MinhHieu15/self-balancing-robot/sbr3/docs/drc_report.txt

** Drc report for SBR3.kicad_pcb **
** Created on 2026-11-12T20:24:28 **
** Report includes: Errors **

** Found 0 DRC violations **

** Found 0 unconnected pads **

** Found 0 Footprint errors **

** Ignored checks **
    - Footprint has no courtyard defined
    - Track endpoint not centered on via
    - Tuning profile track geometries
    - Footprint doesn't match symbol's footprint filters
    - PTH inside courtyard
    - NPTH inside courtyard
    - Footprint component type doesn't match footprint pads

** End of Report **
