MinhHieu15/self-balancing-robot/docs/sim_push.png

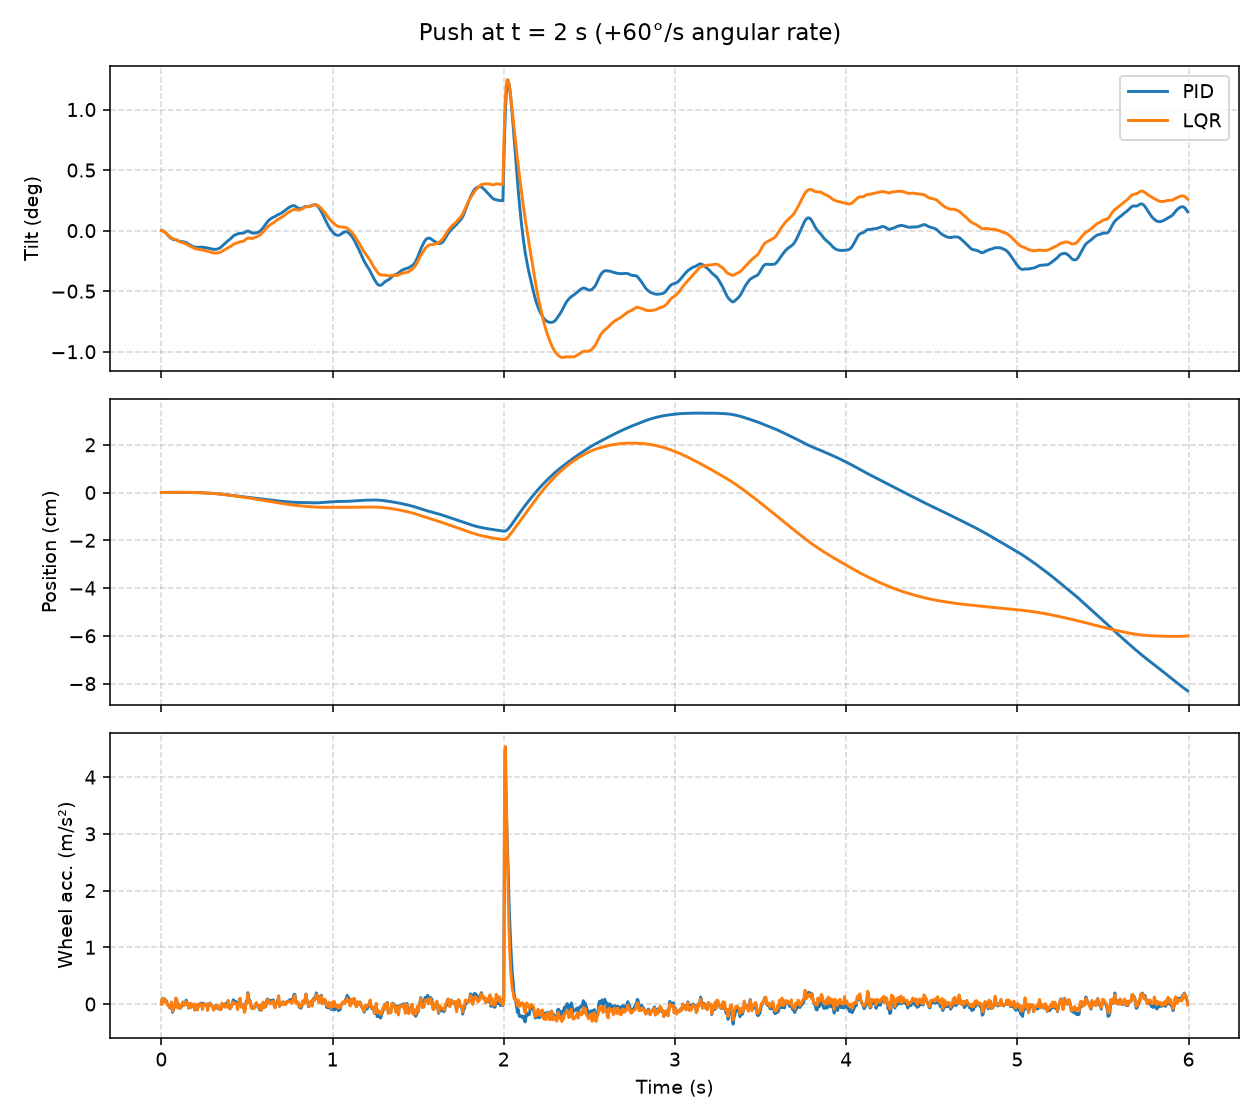
docs/sim_push.png
