MinhHieu15/self-balancing-robot/sbr3/docs/SBR3_3d_overview_back.png

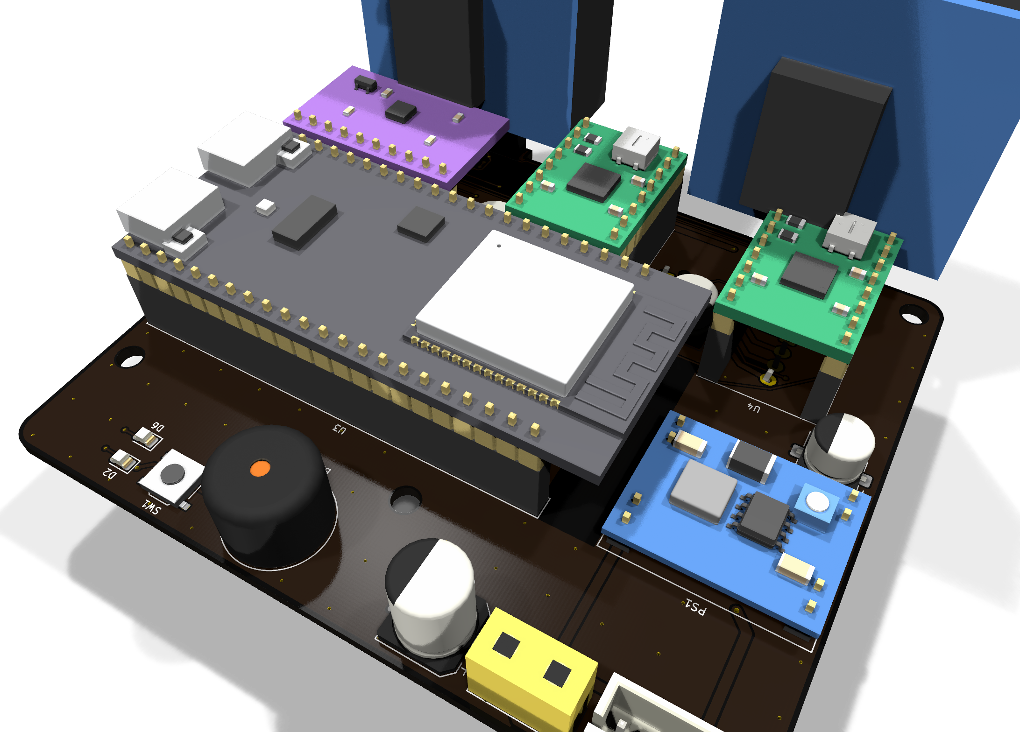
sbr3/docs/SBR3_3d_overview_back.png
