MinhHieu15/self-balancing-robot/sbr3/SBR3_BOM.csv

Reference | Value | Footprint | Qty
BZ1 | Buzzer 5V | workspace_components_Buzzer:Buzzer_12x9.5RM7.6 | 1
C1,C2,C5 | 10uF 10V X5R | stdlib_kicad-footprints_Capacitor_SMD:C_0805_2012Metric | 3
C3,C4,C6,C7,C10,C19,C21 | 100nF 16V X7R | stdlib_kicad-footprints_Capacitor_SMD:C_0805_2012Metric | 7
C8,C11 | 47uF 35V | workspace_components_CP_47uF_35V:CP_Elec_6.3x5.8 | 2
C9,C12,C14 | 100nF 50V X7R | stdlib_kicad-footprints_Capacitor_SMD:C_0805_2012Metric | 3
C13 | 10uF 50V X5R | stdlib_kicad-footprints_Capacitor_SMD:C_1206_3216Metric | 1
C15 | 22uF 25V X5R | stdlib_kicad-footprints_Capacitor_SMD:C_1206_3216Metric | 1
C16 | 22nF 50V X7R | stdlib_kicad-footprints_Capacitor_SMD:C_0805_2012Metric | 1
C17 | 680nF 25V X7R | stdlib_kicad-footprints_Capacitor_SMD:C_0805_2012Metric | 1
C18 | 100uF 16V | workspace_components_CP_100uF_16V:CP_Elec_6.3x5.8 | 1
C20 | 100uF 35V | workspace_components_CP_100uF_35V:CP_Elec_8x10 | 1
D1 | 3A 40V Schottky Rectifier | stdlib_kicad-footprints_Diode_SMD:D_SMA | 1
D2 | LED GREEN | stdlib_kicad-footprints_LED_SMD:LED_0805_2012Metric | 1
D3 | 10V Zener | stdlib_kicad-footprints_Diode_SMD:D_SOD-123 | 1
D4 | 15V TVS Diode | stdlib_kicad-footprints_Diode_SMD:D_SMB | 1
D5 | 75V PN Rectifier | stdlib_kicad-footprints_Diode_SMD:D_SOD-123 | 1
D6 | LED BLUE | stdlib_kicad-footprints_LED_SMD:LED_0805_2012Metric | 1
F1 | PTC 2.6A hold 33V | workspace_components_Polyfuse:Fuse_2920_7451Metric | 1
J1,J2 | Conn_01x05 | workspace_components_Conn_01x05:PinSocket_1x05_P2.54mm_Vertical | 2
J3,J4,J6 | Conn_01x04 | workspace_components_Conn_01x04:JST_XH_B4B-XH-AM_1x04_P2.50mm_Vertical | 3
J5 | Conn_01x02 | workspace_components_Conn_01x02:AMASS_XT30U-M_1x02_P5.0mm_Vertical | 1
PS1 | MP1584EN_Module | workspace_components_MP1584EN_Module:MP1584EN_Module_22x17mm | 1
Q1,Q2 | AO3401A | workspace_components_AO3401A:SOT-23 | 2
Q3 | MMBT3904 | workspace_components_MMBT3904:SOT-23 | 1
R1,R2,R5,R11,R13 | 10k | stdlib_kicad-footprints_Resistor_SMD:R_0805_2012Metric | 5
R3,R4 | 4.7k | stdlib_kicad-footprints_Resistor_SMD:R_0805_2012Metric | 2
R6,R12 | 1k | stdlib_kicad-footprints_Resistor_SMD:R_0805_2012Metric | 2
R7 | 220k | stdlib_kicad-footprints_Resistor_SMD:R_0805_2012Metric | 1
R8 | 0 | stdlib_kicad-footprints_Resistor_SMD:R_0805_2012Metric | 1
R9 | 22k | stdlib_kicad-footprints_Resistor_SMD:R_0805_2012Metric | 1
R10 | 100k | stdlib_kicad-footprints_Resistor_SMD:R_0805_2012Metric | 1
R14 | 330 | stdlib_kicad-footprints_Resistor_SMD:R_0805_2012Metric | 1
SW1 | SW_Push | workspace_components_SW_Push:SW_Push_1P1T_XKB_TS-1187A | 1
U1 | 74AHCT125 | workspace_components_74AHCT125:SOIC-14_3.9x8.7mm_P1.27mm | 1
U2 | GY-9250 | workspace_components_GY-9250:PinSocket_1x10_P2.54mm_Vertical | 1
U3 | ESP32-S3-DevKitC-1 | workspace_components_ESP32-S3-DevKitC-1:ESP32-S3-DevKitC-1 | 1
U4,U5 | A4988_STEPPER_MOTOR_DRIVER_CARRIER | workspace_components_A4988_STEPPER_MOTOR_DRIVER_CARRIER:MODULE_A4988_STEPPER_MOTOR_DRIVER_CARRIER | 2
