MinhHieu15/self-balancing-robot/mechanical/robot_assembly.step

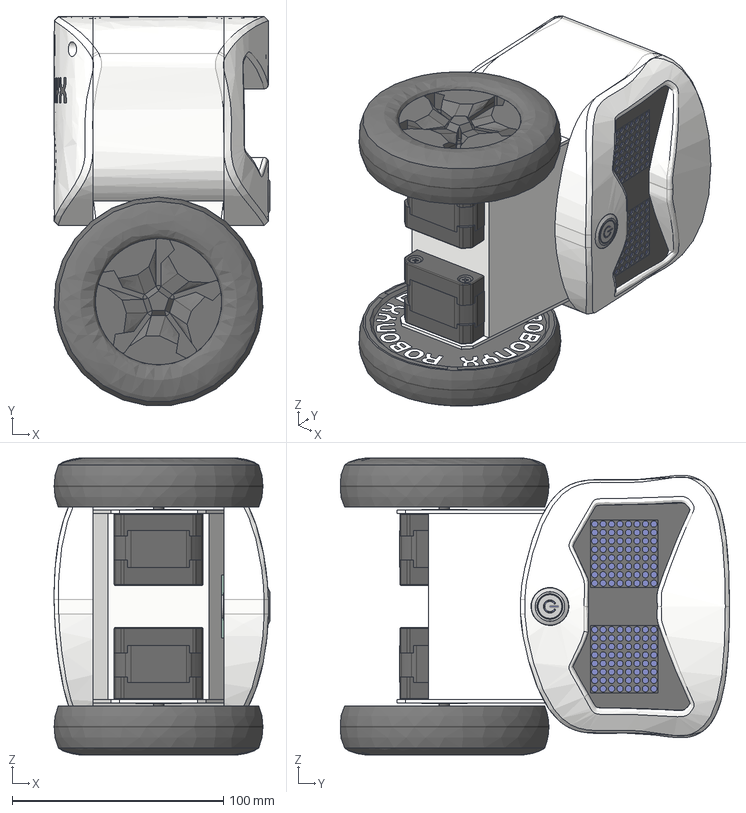
[picture p12: CAD file, 2026-11-12]
mechanical/robot_assembly.step
102.1 x 184.2 x 140.6 mm
pololu-universal-aluminum-mounting-hub-for-5mm-shaft-4-40-holes v1 x 2
Motor x 2
Board_8x8_Dot_Matrix x 2
LED_Matrix x 2
hdrf-1x8t_2.54_21x3 x 4
Metal LED Illuminated Latching 16mm Power Push Button ON-OFF Switch 1 2V (1)
Metal LED Illuminated Latching 16mm Power Push Button ON-OFF Switch 1 2V (2)
Motor Mount v1
CP_Radial_D63mm_P250mm x 2
R_0805_2012Metric_1 x 3
A4988 STEPPER MOTOR DRIVER CARRIER BLACK x 2
C_0805_2012Metric_1 x 3
LED_D5.0mm_1
CQ assembly
PinSocket_1x05_P254mm_Vertical x 2
Adafruit BNO055 STEMMA QT with headers v1
ESP32-DEVKITC_1
D_DO-35_SOD27_P10.16mm_Horizontal_1
JST_B4B_XH_A x 2
SBR2.1_PCB
