MinhHieu15/self-balancing-robot/simulation/results/filter_alpha.csv

alpha | angle_rmse_deg
0.9 | 0.3499
0.94 | 0.2760
0.96 | 0.2385
0.98 | 0.2376
0.99 | 0.3793
0.995 | 0.6984
0.998 | 1.3652
