MinhHieu15/self-balancing-robot/simulation/results/loop_delay.csv

delay_ms | ITAE_PID | ITAE_LQR
0.0 | 0.0525 | 0.0715
5.0 | 0.0529 | 0.0717
10.0 | 0.0534 | 0.0721
15.0 | 0.0540 | 0.0727
20.0 | 0.0557 | 0.0736
25.0 | 0.0822 | 0.0765
30.0 | 0.9472 | 0.5743
35.0 | nan | 0.8431
40.0 | nan | 1.1997
