MinhHieu15/self-balancing-robot/simulation/results/push_lqr.csv

t_s | x_m | v_mps | theta_deg | theta_est_deg | omega_dps | wheel_acc_mps2
0.000 | 0.0000 | 0.0000 | 0.000 | 0.017 | 0.00 | 0.000
0.005 | 0.0000 | 0.0005 | -0.001 | 0.026 | -0.39 | 0.101
0.010 | 0.0000 | 0.0006 | -0.003 | 0.056 | -0.46 | 0.018
0.015 | 0.0000 | 0.0010 | -0.006 | 0.042 | -0.79 | 0.087
0.020 | 0.0000 | 0.0014 | -0.011 | 0.053 | -1.10 | 0.079
0.025 | 0.0000 | 0.0017 | -0.017 | 0.053 | -1.31 | 0.053
0.030 | 0.0000 | 0.0019 | -0.024 | 0.027 | -1.49 | 0.044
0.035 | 0.0000 | 0.0018 | -0.032 | 0.009 | -1.44 | -0.016
0.040 | 0.0000 | 0.0018 | -0.039 | 0.006 | -1.44 | -0.007
0.045 | 0.0001 | 0.0016 | -0.046 | -0.022 | -1.30 | -0.044
0.050 | 0.0001 | 0.0013 | -0.052 | -0.026 | -1.10 | -0.061
0.055 | 0.0001 | 0.0010 | -0.057 | 0.014 | -0.93 | -0.055
0.060 | 0.0001 | 0.0012 | -0.062 | -0.075 | -1.10 | 0.037
0.065 | 0.0001 | 0.0005 | -0.066 | -0.083 | -0.65 | -0.131
0.070 | 0.0001 | 0.0001 | -0.068 | -0.075 | -0.36 | -0.086
0.075 | 0.0001 | -0.0000 | -0.070 | -0.012 | -0.31 | -0.026
0.080 | 0.0001 | -0.0002 | -0.071 | -0.016 | -0.27 | -0.023
0.085 | 0.0001 | 0.0004 | -0.074 | 0.007 | -0.73 | 0.109
0.090 | 0.0001 | 0.0007 | -0.079 | -0.015 | -1.04 | 0.069
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
