MinhHieu15/self-balancing-robot/simulation/results/push_pid.csv

t_s | x_m | v_mps | theta_deg | theta_est_deg | omega_dps | wheel_acc_mps2
0.000 | 0.0000 | 0.0000 | 0.000 | 0.017 | 0.00 | 0.000
0.005 | 0.0000 | 0.0004 | -0.001 | 0.026 | -0.34 | 0.088
0.010 | 0.0000 | 0.0006 | -0.003 | 0.057 | -0.44 | 0.027
0.015 | 0.0000 | 0.0011 | -0.006 | 0.043 | -0.81 | 0.097
0.020 | 0.0000 | 0.0015 | -0.011 | 0.053 | -1.14 | 0.083
0.025 | 0.0000 | 0.0018 | -0.017 | 0.053 | -1.39 | 0.065
0.030 | 0.0000 | 0.0021 | -0.025 | 0.026 | -1.62 | 0.057
0.035 | 0.0000 | 0.0021 | -0.033 | 0.008 | -1.62 | -0.006
0.040 | 0.0001 | 0.0020 | -0.041 | 0.004 | -1.61 | -0.009
0.045 | 0.0001 | 0.0018 | -0.049 | -0.025 | -1.47 | -0.043
0.050 | 0.0001 | 0.0014 | -0.056 | -0.030 | -1.24 | -0.070
0.055 | 0.0001 | 0.0011 | -0.061 | 0.010 | -1.02 | -0.068
0.060 | 0.0001 | 0.0012 | -0.067 | -0.080 | -1.15 | 0.025
0.065 | 0.0001 | 0.0005 | -0.071 | -0.088 | -0.64 | -0.147
0.070 | 0.0001 | -0.0001 | -0.073 | -0.080 | -0.25 | -0.113
0.075 | 0.0001 | -0.0004 | -0.074 | -0.017 | -0.08 | -0.058
0.080 | 0.0001 | -0.0005 | -0.074 | -0.019 | -0.04 | -0.022
0.085 | 0.0001 | -0.0000 | -0.075 | 0.005 | -0.43 | 0.089
0.090 | 0.0001 | 0.0003 | -0.078 | -0.015 | -0.74 | 0.068
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
