MinhHieu15/self-balancing-robot/simulation/results/tilt10_lqr.csv

t_s | x_m | v_mps | theta_deg | theta_est_deg | omega_dps | wheel_acc_mps2
0.000 | 0.0000 | 0.0000 | 10.018 | 10.017 | 6.51 | 0.000
0.005 | 0.0001 | 0.0300 | 10.006 | 10.059 | -9.54 | 6.000
0.010 | 0.0003 | 0.0600 | 9.914 | 10.043 | -25.62 | 6.000
0.015 | 0.0007 | 0.0900 | 9.742 | 9.905 | -41.80 | 6.000
0.020 | 0.0012 | 0.1152 | 9.498 | 9.712 | -54.50 | 5.040
0.025 | 0.0018 | 0.1349 | 9.202 | 9.447 | -63.22 | 3.930
0.030 | 0.0026 | 0.1499 | 8.871 | 9.114 | -68.69 | 3.013
0.035 | 0.0033 | 0.1612 | 8.519 | 8.764 | -71.55 | 2.262
0.040 | 0.0042 | 0.1701 | 8.158 | 8.413 | -72.78 | 1.765
0.045 | 0.0050 | 0.1769 | 7.795 | 8.031 | -72.71 | 1.360
0.050 | 0.0059 | 0.1822 | 7.434 | 7.673 | -71.81 | 1.076
0.055 | 0.0069 | 0.1867 | 7.079 | 7.362 | -70.42 | 0.885
0.060 | 0.0078 | 0.1908 | 6.730 | 6.928 | -69.05 | 0.830
0.065 | 0.0088 | 0.1936 | 6.391 | 6.583 | -66.85 | 0.550
0.070 | 0.0097 | 0.1961 | 6.063 | 6.263 | -64.70 | 0.507
0.075 | 0.0107 | 0.1986 | 5.745 | 6.006 | -62.72 | 0.497
0.080 | 0.0117 | 0.2008 | 5.437 | 5.692 | -60.74 | 0.441
0.085 | 0.0127 | 0.2034 | 5.137 | 5.415 | -59.26 | 0.522
0.090 | 0.0138 | 0.2056 | 4.846 | 5.102 | -57.66 | 0.438
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
