MinhHieu15/self-balancing-robot/sbr3/docs/SBR3_schematic.pdf

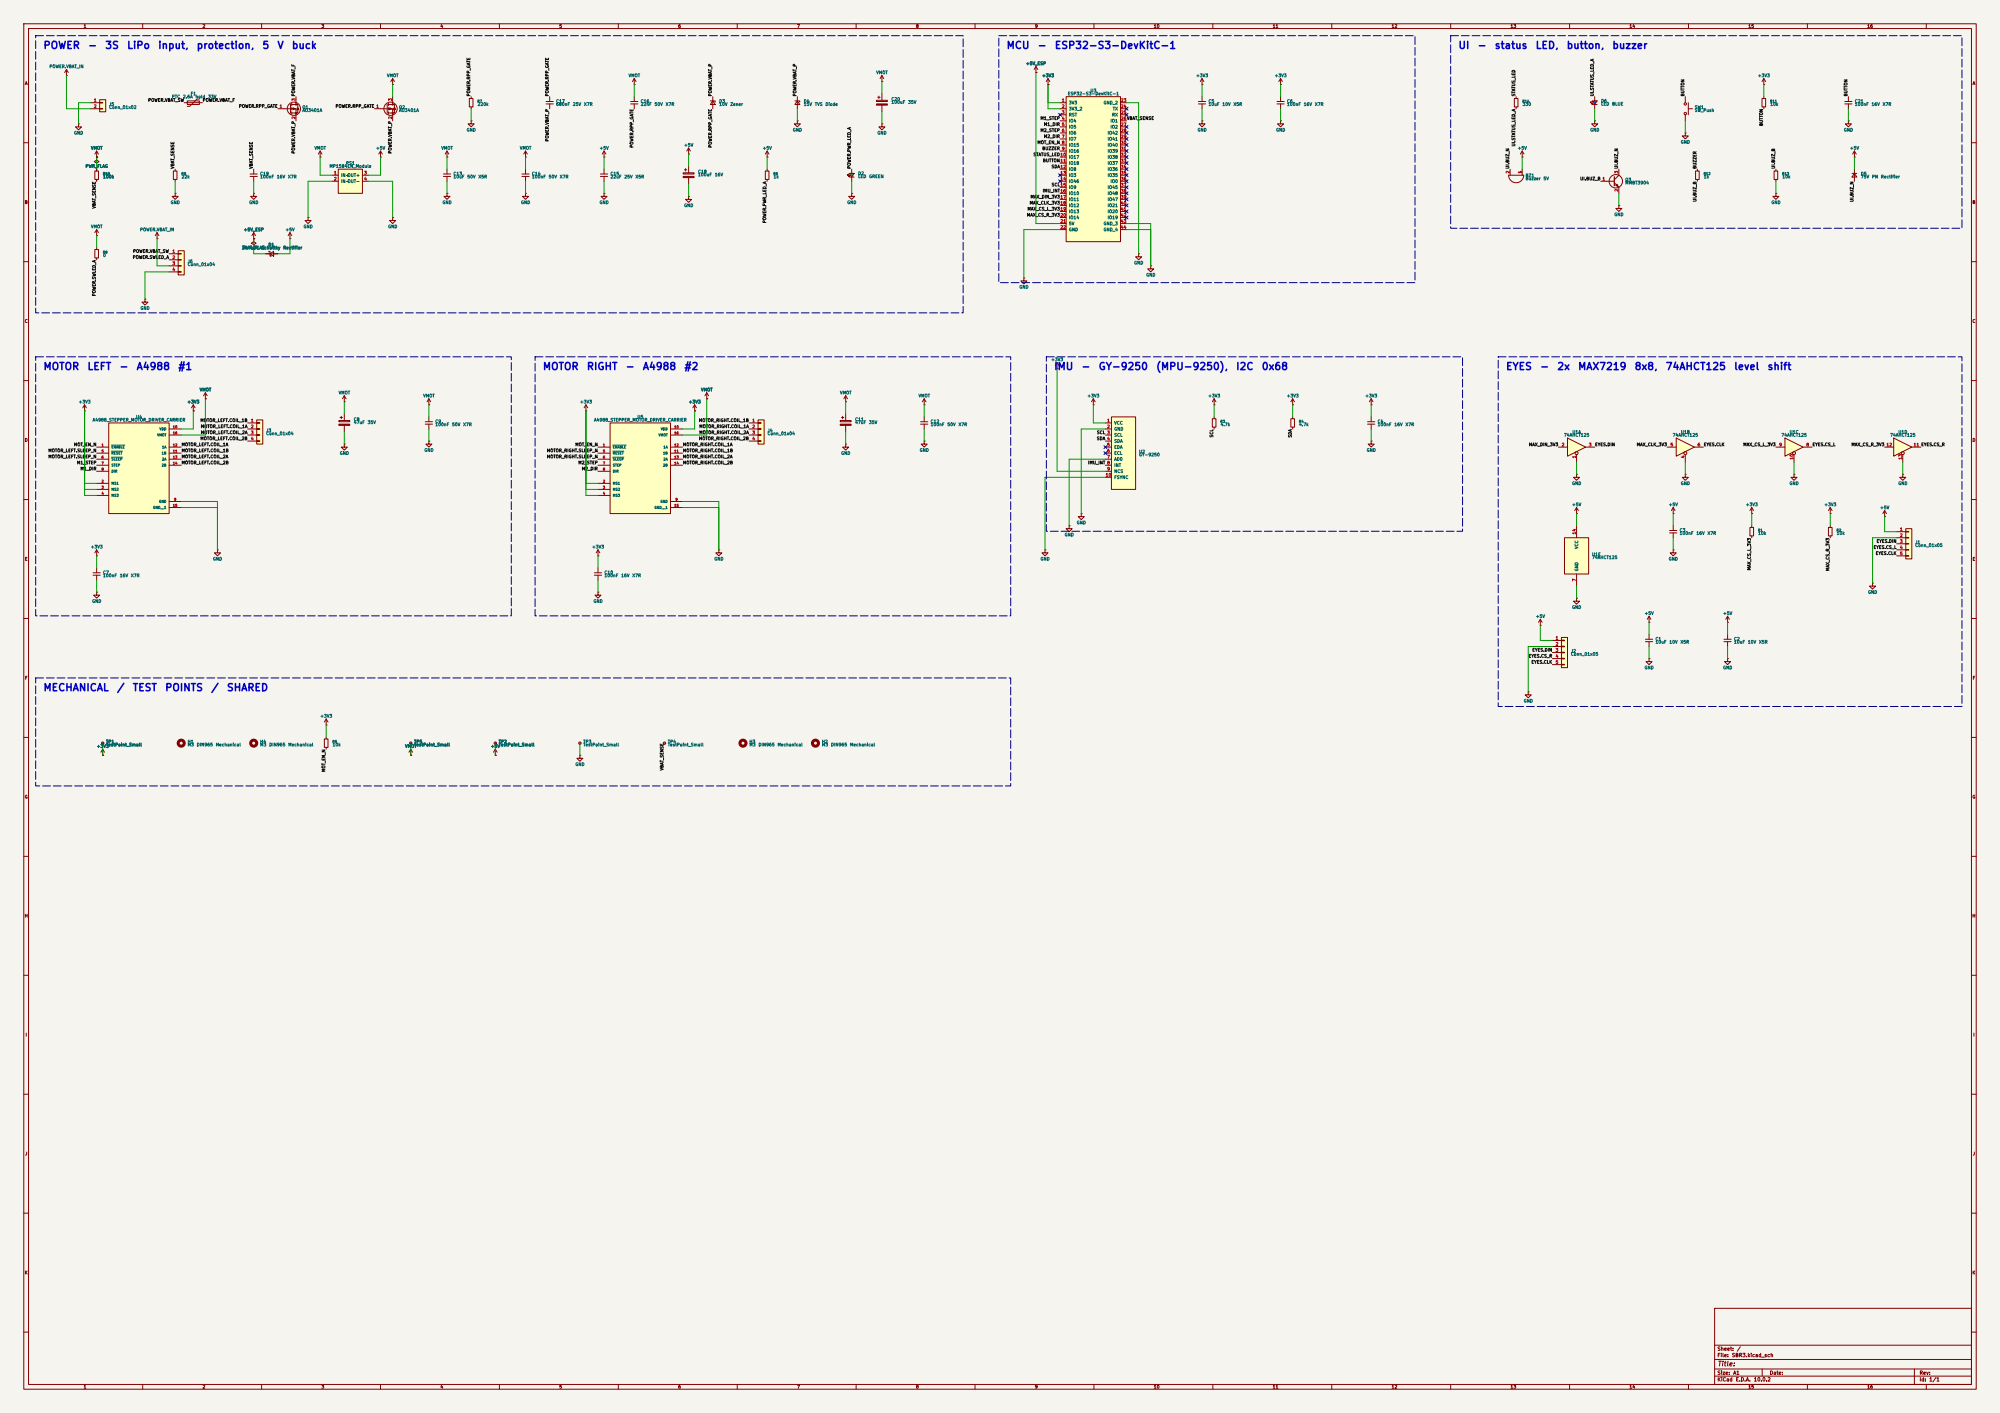
[picture p13: page 1]

UI - status LED, button, buzzer

Size: A1 | Rev:
KiCad E.D.A. 10.0.2 | Id: 1/1
