MinhHieu15/self-balancing-robot/sbr3/docs/SBR3_bottom_copper.pdf

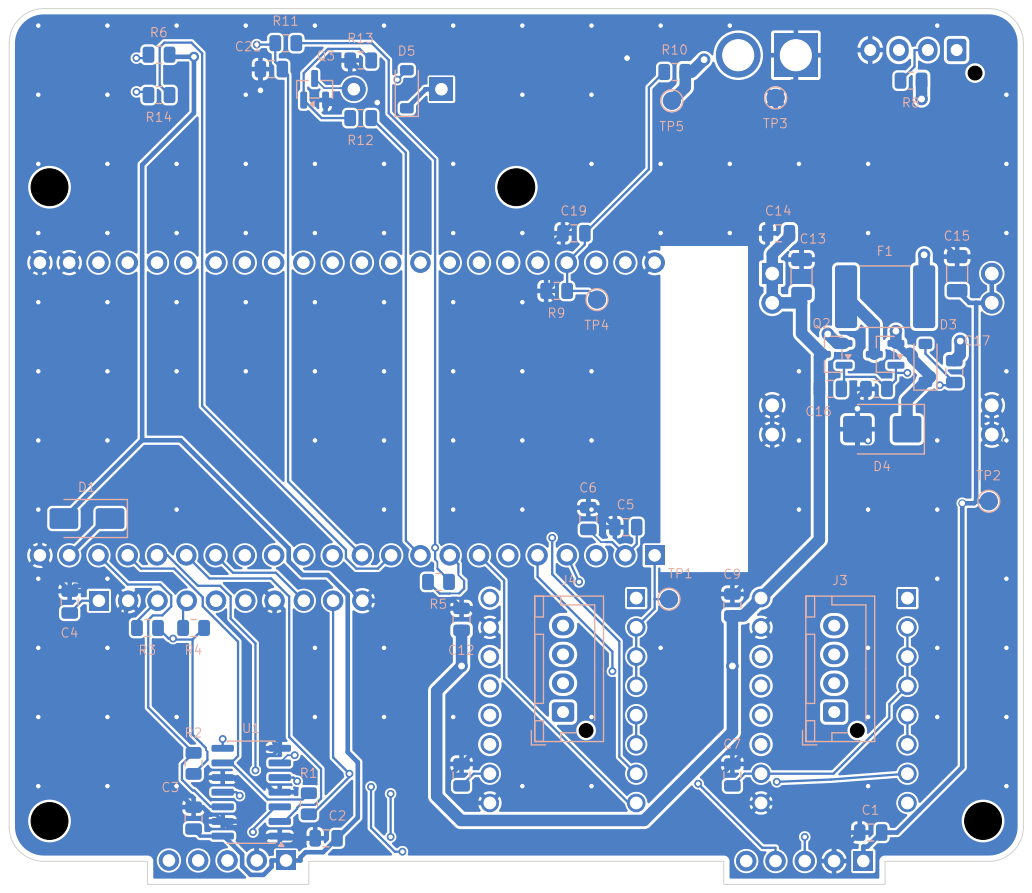
[picture p14: page 1]
