MinhHieu15/self-balancing-robot/sbr3/docs/SBR3_top_copper.pdf

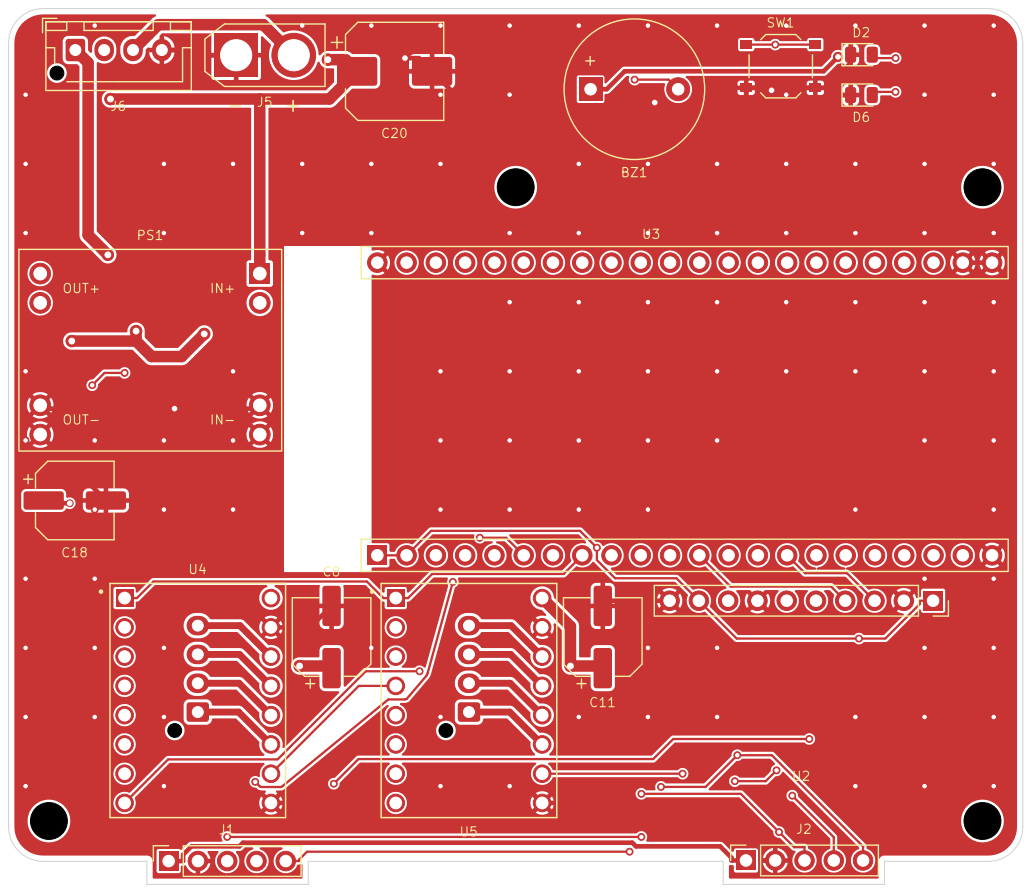
[picture p15: page 1]
