MinhHieu15/self-balancing-robot/sbr3/kicad/SBR3.kicad_pcb

## KiCad design sbr3/kicad/SBR3.kicad_pcb (2026-11-12)

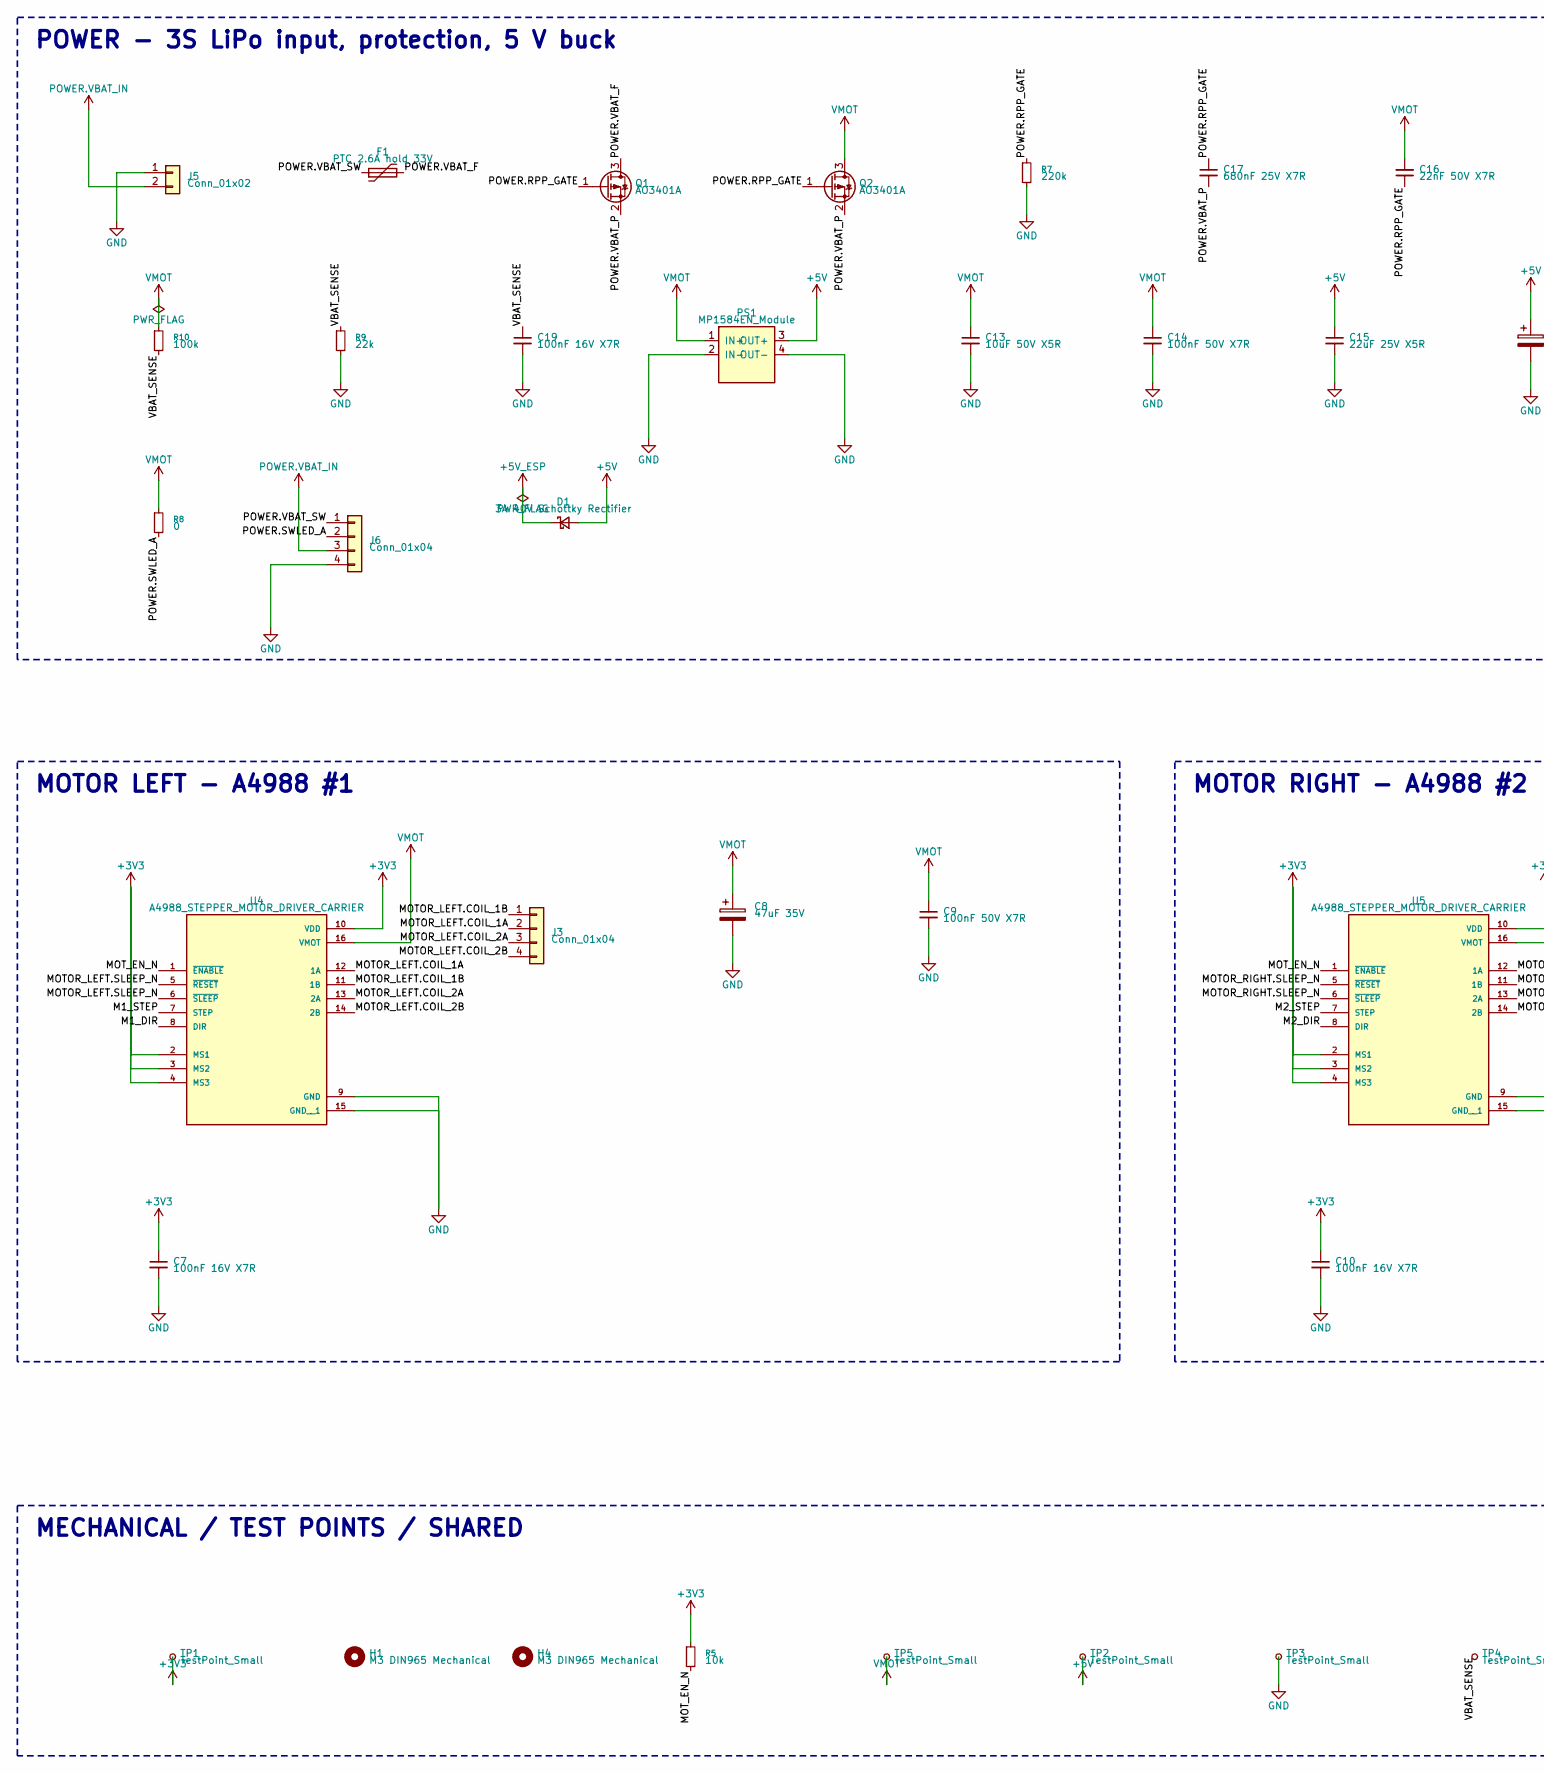
[picture p16: schematic SBR3.kicad_sch, part in row 1, column 1]

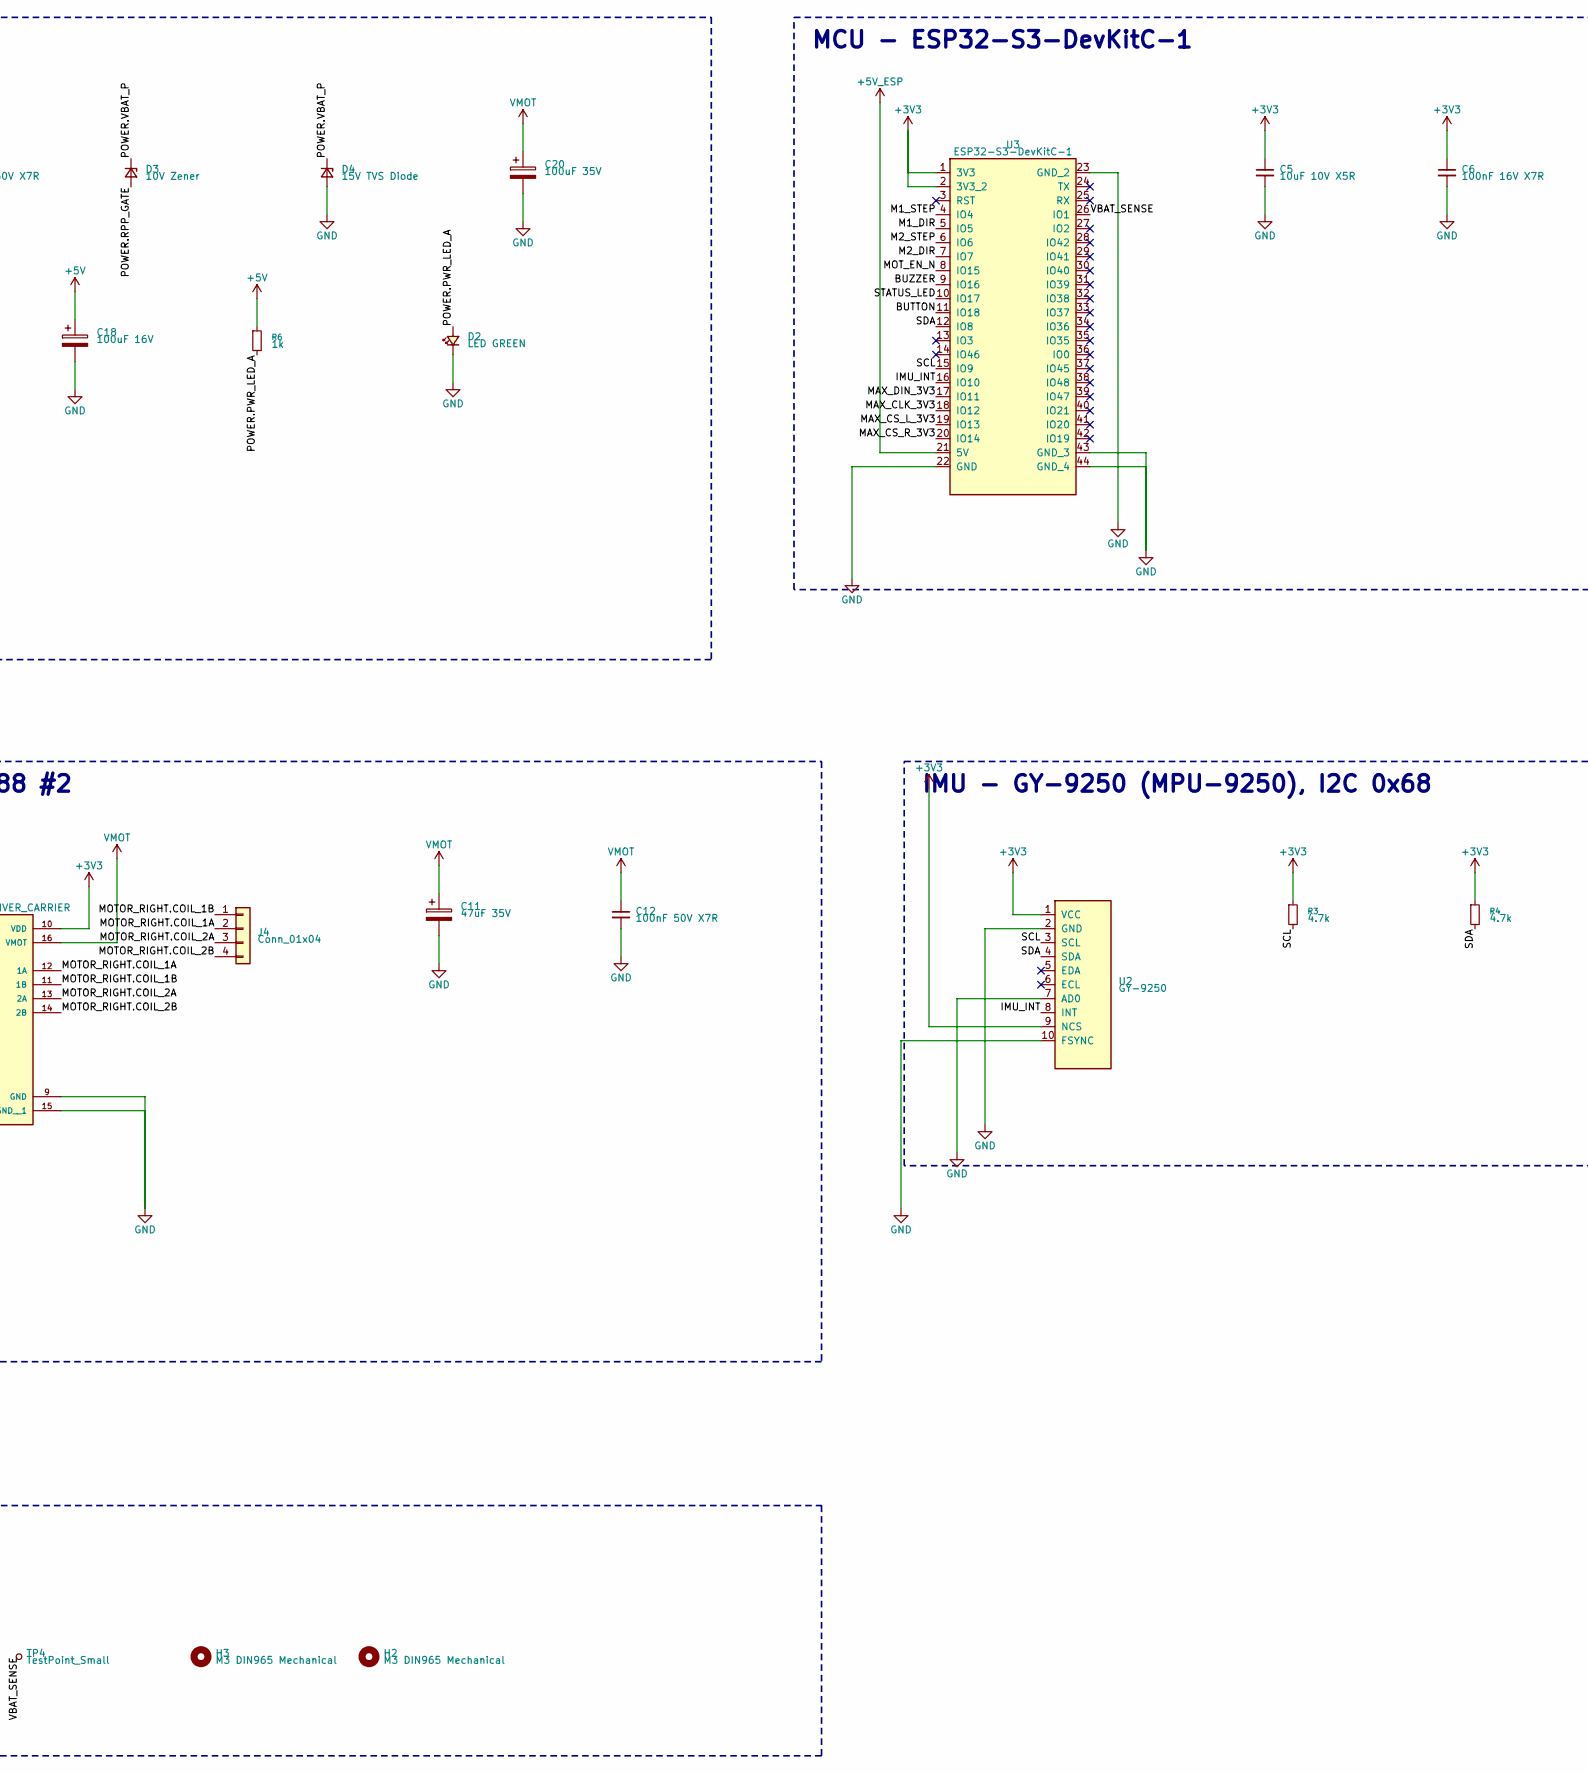
[picture p17: schematic SBR3.kicad_sch, part in row 1, column 2]

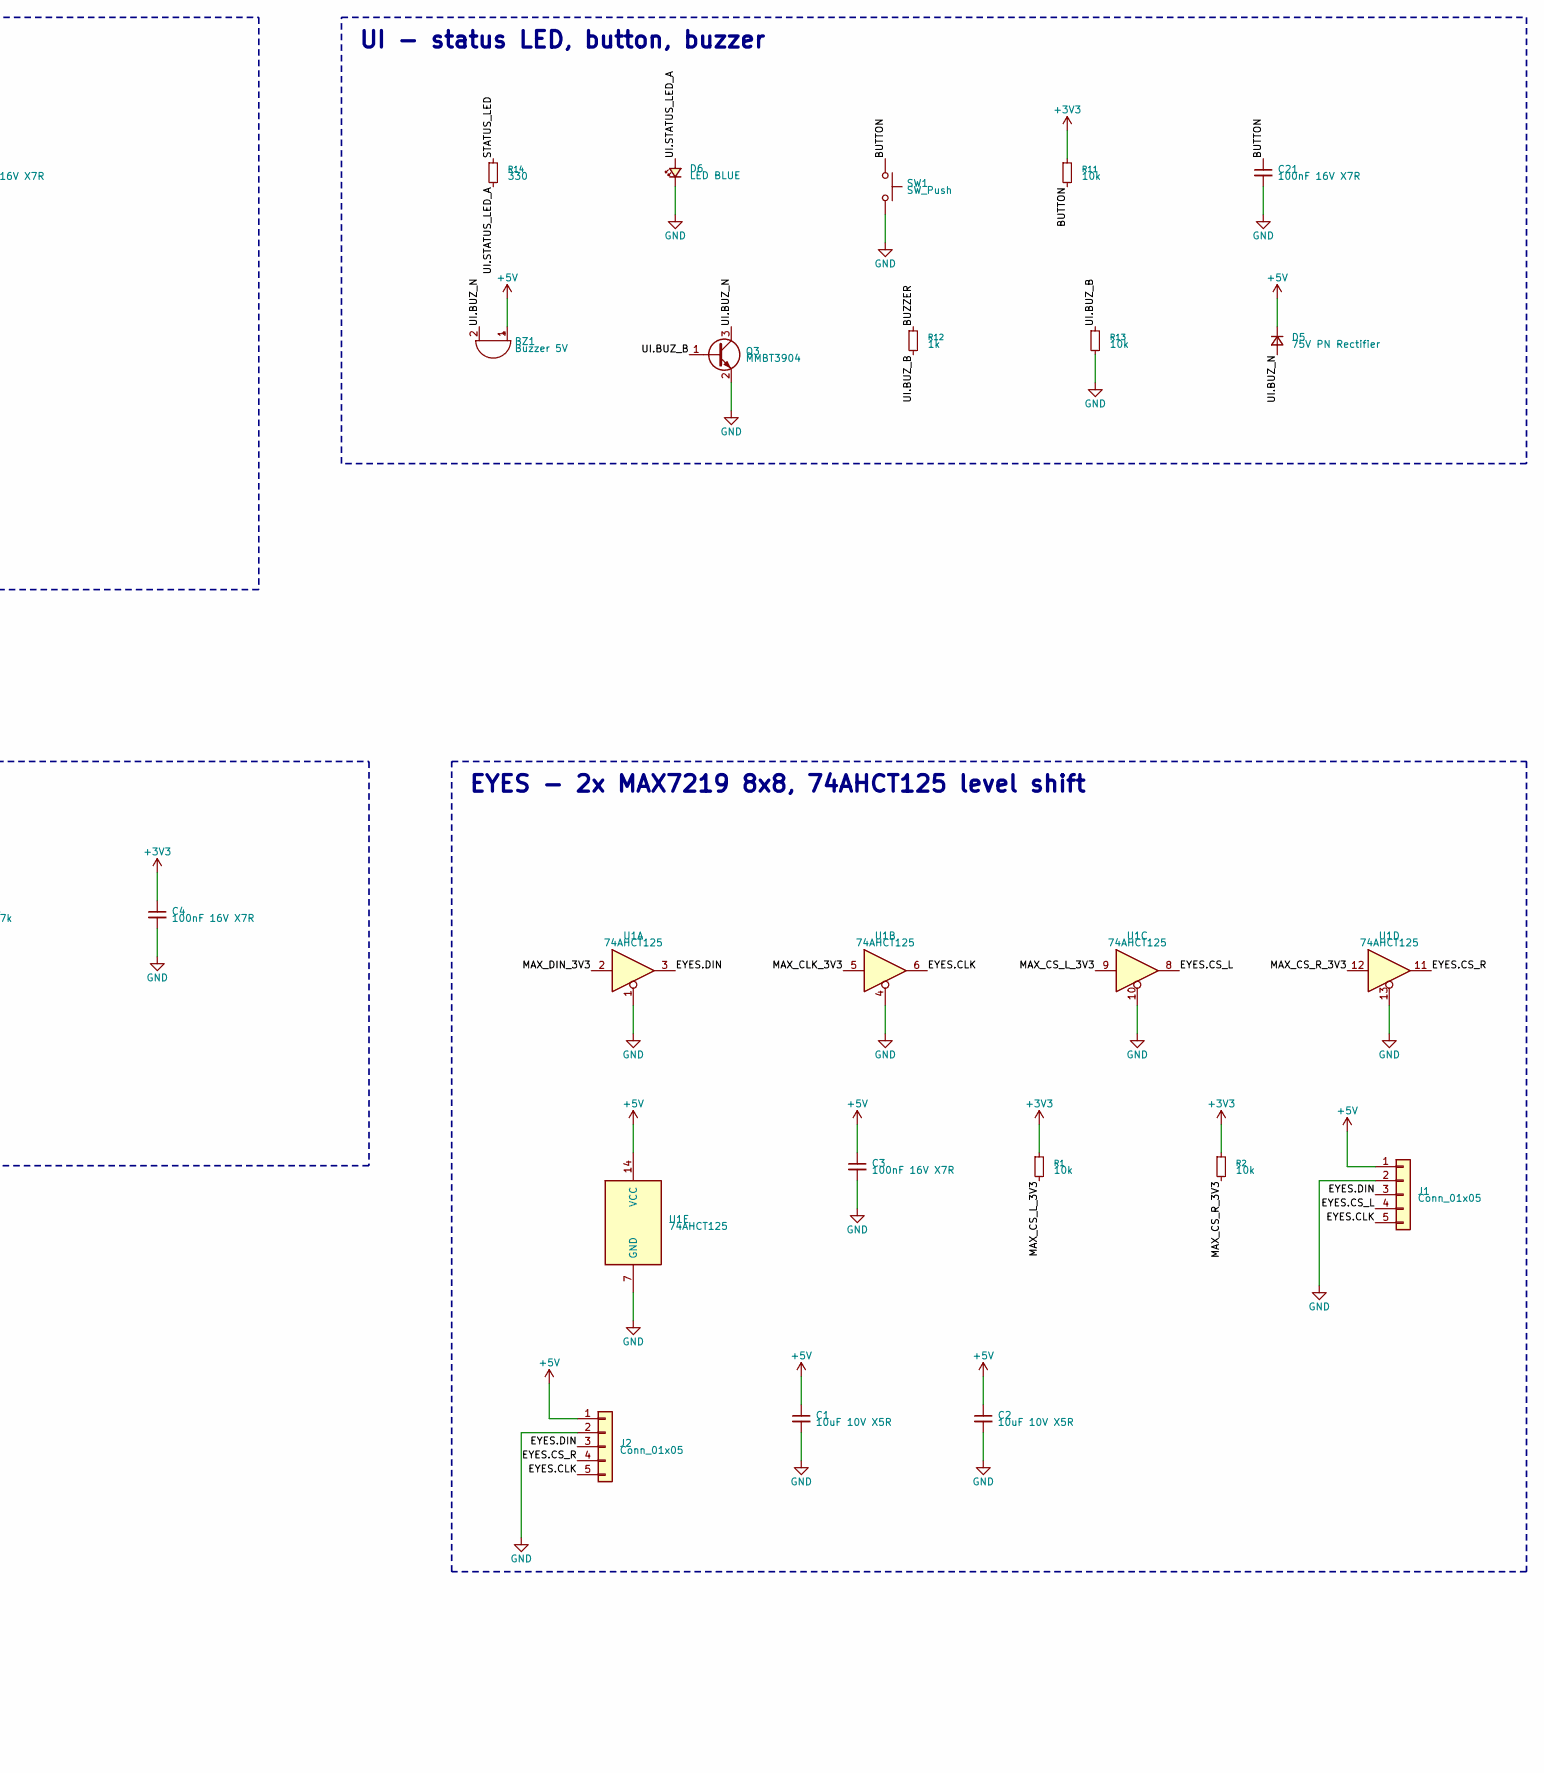
[picture p18: schematic SBR3.kicad_sch, part in row 1, column 3]

Parts:
BZ1: Buzzer 5V; Buzzer_12x9.5RM7.6
C1, C2, C5: 10uF 10V X5R; C_0805_2012Metric
C3, C4, C6, C7, C10, C19, C21: 100nF 16V X7R; C_0805_2012Metric
C8, C11: 47uF 35V; CP_Elec_6.3x5.8
C9, C12, C14: 100nF 50V X7R; C_0805_2012Metric
C13: 10uF 50V X5R; C_1206_3216Metric
C15: 22uF 25V X5R; C_1206_3216Metric
C16: 22nF 50V X7R; C_0805_2012Metric
C17: 680nF 25V X7R; C_0805_2012Metric
C18: 100uF 16V; CP_Elec_6.3x5.8
C20: 100uF 35V; CP_Elec_8x10
D1: 3A 40V Schottky Rectifier; D_SMA
D2: LED GREEN; LED_0805_2012Metric
D3: 10V Zener; D_SOD-123
D4: 15V TVS Diode; D_SMB
D5: 75V PN Rectifier; D_SOD-123
D6: LED BLUE; LED_0805_2012Metric
F1: PTC 2.6A hold 33V; Fuse_2920_7451Metric
H1, H2, H3, H4: M3 DIN965 Mechanical; MountingHole_3.2mm_M3_DIN965
J1, J2: Conn_01x05; PinSocket_1x05_P2.54mm_Vertical
J3, J4, J6: Conn_01x04; JST_XH_B4B-XH-AM_1x04_P2.50mm_Vertical
J5: Conn_01x02; AMASS_XT30U-M_1x02_P5.0mm_Vertical
PS1: MP1584EN_Module; MP1584EN_Module_22x17mm
Q1, Q2: AO3401A; SOT-23
Q3: MMBT3904; SOT-23
R1, R2, R5, R11, R13: 10k; R_0805_2012Metric
R3, R4: 4.7k; R_0805_2012Metric
R6, R12: 1k; R_0805_2012Metric
R7: 220k; R_0805_2012Metric
R8: 0; R_0805_2012Metric
R9: 22k; R_0805_2012Metric
R10: 100k; R_0805_2012Metric
R14: 330; R_0805_2012Metric
SW1: SW_Push; SW_Push_1P1T_XKB_TS-1187A
TP1, TP2, TP3, TP4, TP5: TestPoint_Small; TestPoint_Pad_D1.5mm
U1: 74AHCT125; SOIC-14_3.9x8.7mm_P1.27mm
U2: GY-9250; PinSocket_1x10_P2.54mm_Vertical
U3: ESP32-S3-DevKitC-1
U4, U5: A4988_STEPPER_MOTOR_DRIVER_CARRIER; MODULE_A4988_STEPPER_MOTOR_DRIVER_CARRIER

Connections:
+3V3: C4.1, C5.1, C6.1, C7.1, C10.1, R1.1, R2.1, R3.1, R4.1, R5.1, R11.1, TP1.1, U2.1 (VCC), U2.9 (NCS), U3.1 (3V3), U3.2 (3V3_2), U4.2 (MS1), U4.3 (MS2), U4.4 (MS3), U4.10 (VDD), U5.2 (MS1), U5.3 (MS2), U5.4 (MS3), U5.10 (VDD)
+5V: BZ1.1 (+), C1.1, C2.1, C3.1, C15.1, C18.1, D1.2 (A), D5.1 (K), J1.1, J2.1, PS1.3 (OUT+), R6.1, TP2.1, U1.14 (VCC)
+5V_ESP: D1.1 (K), U3.21 (5V)
BUTTON: C21.1, R11.2, SW1.1, U3.11 (IO18)
BUZZER: R12.1, U3.9 (IO16)
EYES.CLK: J1.5, J2.5, U1.6
EYES.CS_L: J1.4, U1.8
EYES.CS_R: J2.4, U1.11
EYES.DIN: J1.3, J2.3, U1.3
GND: C1.2, C2.2, C3.2, C4.2, C5.2, C6.2, C7.2, C8.2, C9.2, C10.2, C11.2, C12.2, C13.2, C14.2, C15.2, C18.2, C19.2, C20.2, C21.2, D2.1 (K), D4.2 (A), D6.1 (K), J1.2, J2.2, J5.1, J6.4, PS1.2 (IN-), PS1.4 (OUT-), Q3.2 (E), R7.2, R9.2, R13.2, SW1.2, TP3.1, U1.1, U1.4, U1.7 (GND), U1.10, U1.13, U2.2 (GND), U2.7 (AD0), U2.10 (FSYNC), U3.22 (GND), U3.23 (GND_2), U3.43 (GND_3), U3.44 (GND_4), U4.9 (GND), U4.15 (GND__1), U5.9 (GND), U5.15 (GND__1)
IMU.IMU.NC_GY-9250_ECL: U2.6 (ECL)
IMU.IMU.NC_GY-9250_EDA: U2.5 (EDA)
IMU_INT: U2.8 (INT), U3.16 (IO10)
M1_DIR: U3.5 (IO5), U4.8 (DIR)
M1_STEP: U3.4 (IO4), U4.7 (STEP)
M2_DIR: U3.7 (IO7), U5.8 (DIR)
M2_STEP: U3.6 (IO6), U5.7 (STEP)
MAX_CLK_3V3: U1.5, U3.18 (IO12)
MAX_CS_L_3V3: R1.2, U1.9, U3.19 (IO13)
MAX_CS_R_3V3: R2.2, U1.12, U3.20 (IO14)
MAX_DIN_3V3: U1.2, U3.17 (IO11)
MCU.DEVKIT.NC_ESP32-S3-DevKitC-1_IO0: U3.36 (IO0)
MCU.DEVKIT.NC_ESP32-S3-DevKitC-1_IO2: U3.27 (IO2)
MCU.DEVKIT.NC_ESP32-S3-DevKitC-1_IO3: U3.13 (IO3)
MCU.DEVKIT.NC_ESP32-S3-DevKitC-1_IO19: U3.42 (IO19)
MCU.DEVKIT.NC_ESP32-S3-DevKitC-1_IO20: U3.41 (IO20)
MCU.DEVKIT.NC_ESP32-S3-DevKitC-1_IO21: U3.40 (IO21)
MCU.DEVKIT.NC_ESP32-S3-DevKitC-1_IO35: U3.35 (IO35)
MCU.DEVKIT.NC_ESP32-S3-DevKitC-1_IO36: U3.34 (IO36)
MCU.DEVKIT.NC_ESP32-S3-DevKitC-1_IO37: U3.33 (IO37)
MCU.DEVKIT.NC_ESP32-S3-DevKitC-1_IO38: U3.32 (IO38)
MCU.DEVKIT.NC_ESP32-S3-DevKitC-1_IO39: U3.31 (IO39)
MCU.DEVKIT.NC_ESP32-S3-DevKitC-1_IO40: U3.30 (IO40)
MCU.DEVKIT.NC_ESP32-S3-DevKitC-1_IO41: U3.29 (IO41)
MCU.DEVKIT.NC_ESP32-S3-DevKitC-1_IO42: U3.28 (IO42)
MCU.DEVKIT.NC_ESP32-S3-DevKitC-1_IO45: U3.37 (IO45)
MCU.DEVKIT.NC_ESP32-S3-DevKitC-1_IO46: U3.14 (IO46)
MCU.DEVKIT.NC_ESP32-S3-DevKitC-1_IO47: U3.39 (IO47)
MCU.DEVKIT.NC_ESP32-S3-DevKitC-1_IO48: U3.38 (IO48)
MCU.DEVKIT.NC_ESP32-S3-DevKitC-1_RST: U3.3 (RST)
MCU.DEVKIT.NC_ESP32-S3-DevKitC-1_RX: U3.25 (RX)
MCU.DEVKIT.NC_ESP32-S3-DevKitC-1_TX: U3.24 (TX)
MOTOR_LEFT.COIL_1A: J3.2, U4.12 (1A)
MOTOR_LEFT.COIL_1B: J3.1, U4.11 (1B)
MOTOR_LEFT.COIL_2A: J3.3, U4.13 (2A)
MOTOR_LEFT.COIL_2B: J3.4, U4.14 (2B)
MOTOR_LEFT.SLEEP_N: U4.5 (~RESET), U4.6 (~SLEEP)
MOTOR_RIGHT.COIL_1A: J4.2, U5.12 (1A)
MOTOR_RIGHT.COIL_1B: J4.1, U5.11 (1B)
MOTOR_RIGHT.COIL_2A: J4.3, U5.13 (2A)
MOTOR_RIGHT.COIL_2B: J4.4, U5.14 (2B)
MOTOR_RIGHT.SLEEP_N: U5.5 (~RESET), U5.6 (~SLEEP)
MOT_EN_N: R5.2, U3.8 (IO15), U4.1 (~ENABLE), U5.1 (~ENABLE)
POWER.PWR_LED_A: D2.2 (A), R6.2
POWER.RPP_GATE: C16.1, C17.1, D3.2 (A), Q1.1 (G), Q2.1 (G), R7.1
POWER.SWLED_A: J6.2, R8.2
POWER.VBAT_F: F1.2, Q1.3 (D)
POWER.VBAT_IN: J5.2, J6.3
POWER.VBAT_P: C17.2, D3.1 (K), D4.1 (K), Q1.2 (S), Q2.2 (S)
POWER.VBAT_SW: F1.1, J6.1
SCL: R3.2, U2.3 (SCL), U3.15 (IO9)
SDA: R4.2, U2.4 (SDA), U3.12 (IO8)
STATUS_LED: R14.1, U3.10 (IO17)
UI.BUZ_B: Q3.1 (B), R12.2, R13.1
UI.BUZ_N: BZ1.2 (-), D5.2 (A), Q3.3 (C)
UI.STATUS_LED_A: D6.2 (A), R14.2
VBAT_SENSE: C19.1, R9.1, R10.2, TP4.1, U3.26 (IO1)
VMOT: C8.1, C9.1, C11.1, C12.1, C13.1, C14.1, C16.2, C20.1, PS1.1 (IN+), Q2.3 (D), R8.1, R10.1, TP5.1, U4.16 (VMOT), U5.16 (VMOT)

Notes on the sheet:
POWER - 3S LiPo input, protection, 5 V buck
UI - status LED, button, buzzer
MCU - ESP32-S3-DevKitC-1
MOTOR LEFT - A4988 #1
IMU - GY-9250 (MPU-9250), I2C 0x68
EYES - 2x MAX7219 8x8, 74AHCT125 level shift
MECHANICAL / TEST POINTS / SHARED
MOTOR RIGHT - A4988 #2

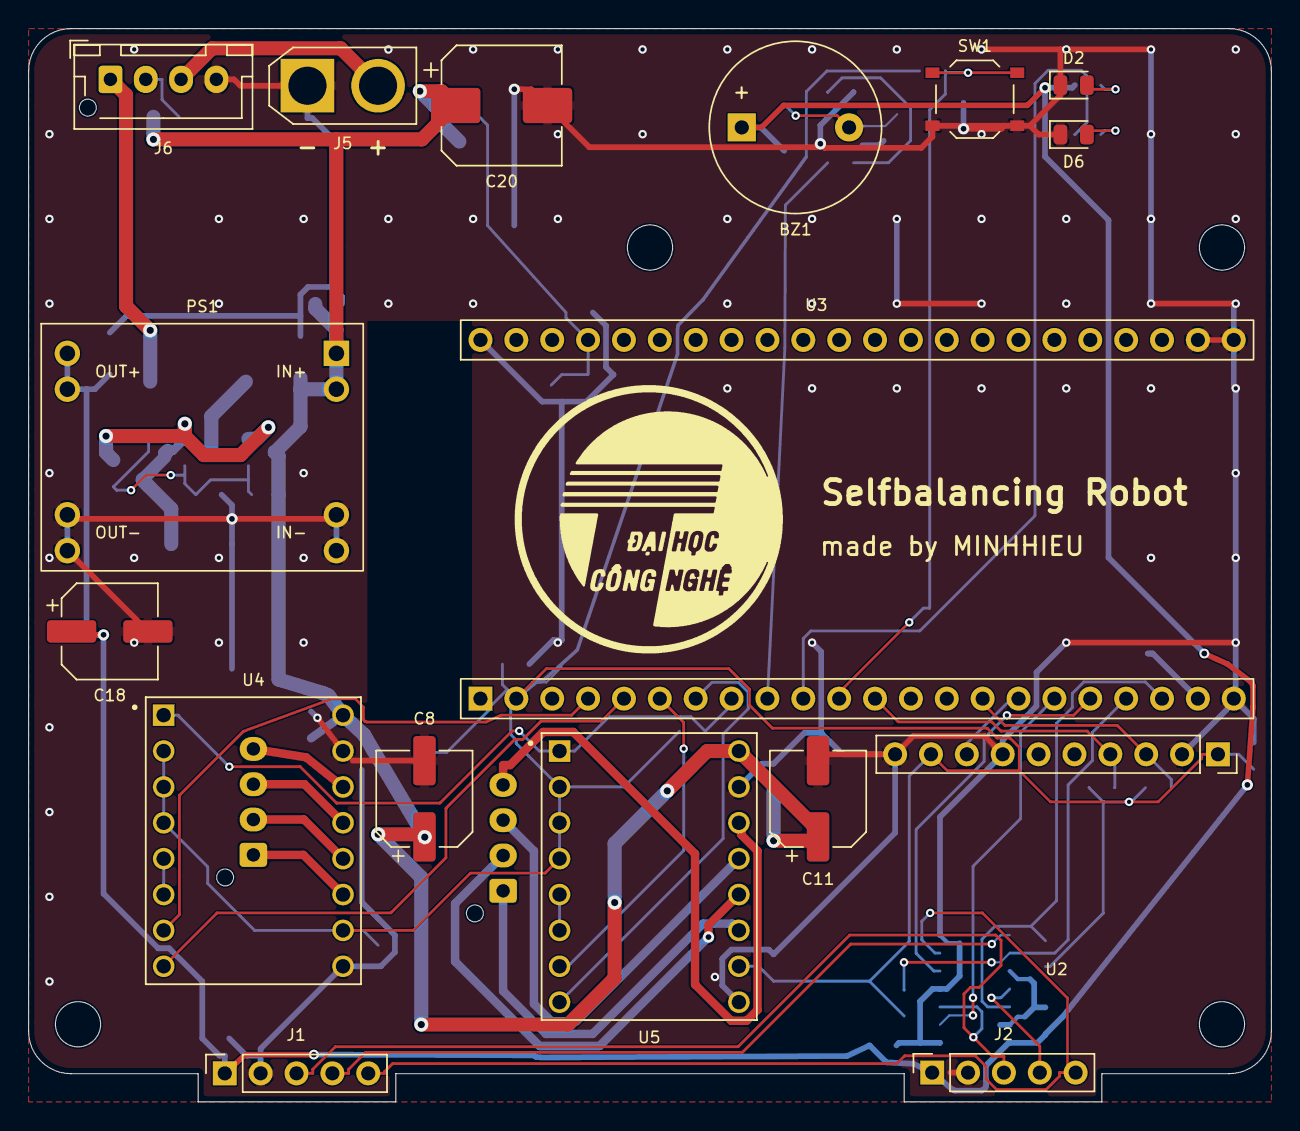
[picture p19: board SBR3.kicad_pcb from above]

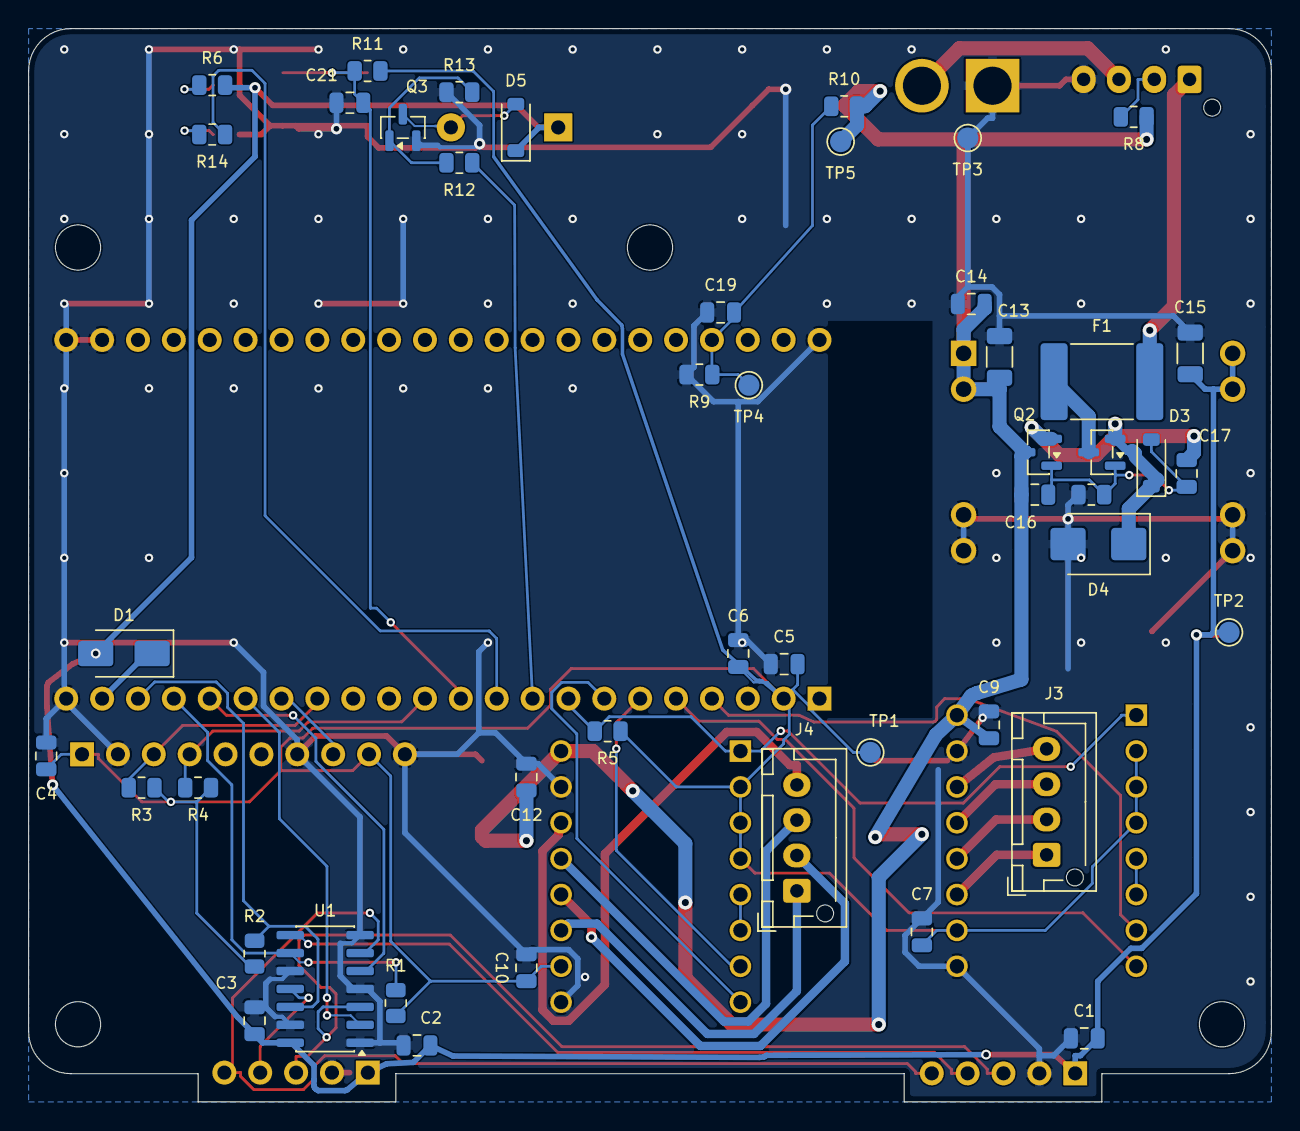
[picture p20: board SBR3.kicad_pcb from below]

Board: 2 copper layers, 88.0 x 76.0 mm, 68 parts (47 on the bottom side), 45 nets.
