MinhHieu15/self-balancing-robot/(commit log)

2026-11-12 Initial commit: self-balancing-robot
    [angle_data.xlsx, teleplot_2026-5-23_13-39.csv]
2026-11-12 Add SBR3 board, robot model and 200 Hz balancing simulation
    [SBR3-B_Cu.gbl, SBR3-B_Mask.gbs, SBR3-B_Paste.gbp, SBR3-B_Silkscreen.gbo, SBR3-Edge_Cuts.gm1, SBR3-F_Cu.gtl, SBR3-F_Mask.gts, SBR3-F_Paste.gtp]
